HexabitzGit/H23R3x-Hardware/README.md

# H23R3x-Hardware
Hexabitz BlueNRG-M2 Bluetooth Module Hardware Design
