HexabitzGit/H23R3x-Hardware/H23R30/Documentation/H23R30_Bot.jpg

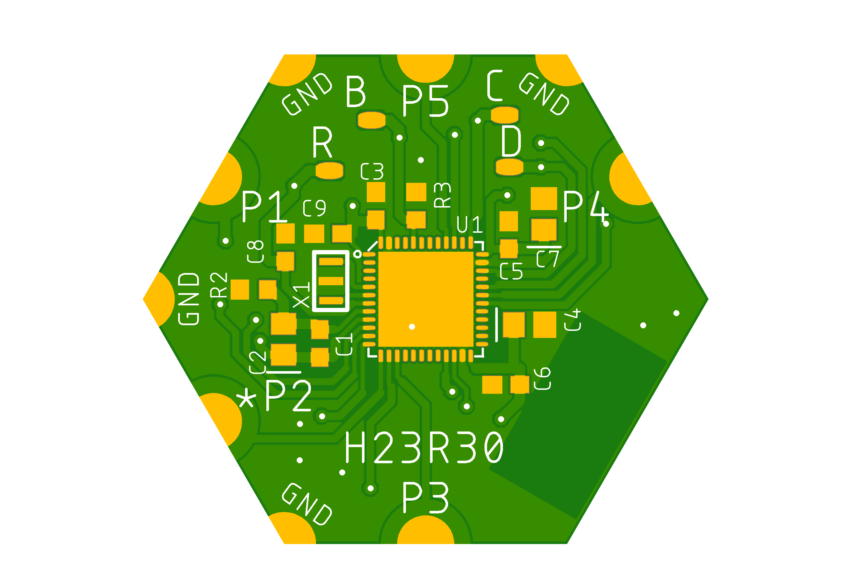
H23R30/Documentation/H23R30_Bot.jpg
