HexabitzGit/H23R3x-Hardware/H23R30/Documentation/H23R30_Top.jpg

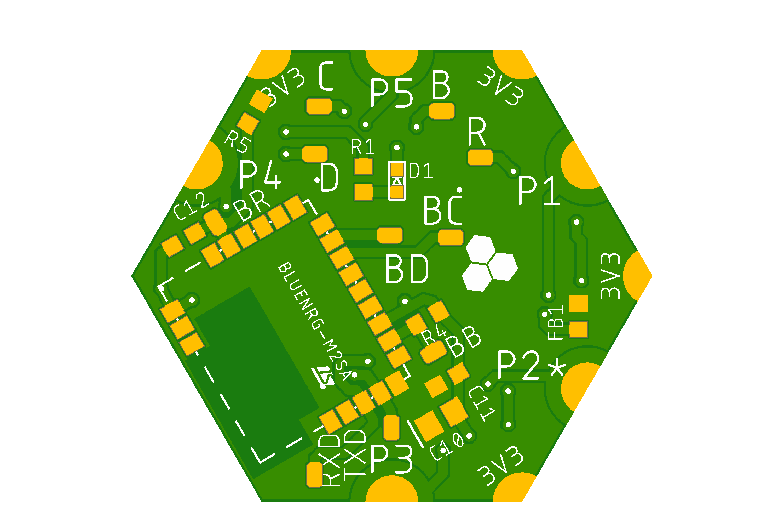
H23R30/Documentation/H23R30_Top.jpg
