HexabitzGit/H23R3x-Hardware/H23R30/Released/BOM/H23R30_BOM.xlsx

Qty | Value | Designator | Description | CAPACITANCE | MFN | MPN | OCTOPART_URL | TOLERANCE
1 | 0.0R | R2 | Thick Film Resistors - SMD 0603 |  | Yageo | RC0603JR-070RL | https://octopart.com/rc0603jr-070rl-yageo-1241539?r=sp&s=X2NteqRjRNWrnx42Y0aliA
1 | 270.0R | R1 | Thick Film Resistors - SMD 0603 |  | Yageo | RC0603FR-07270RL | https://octopart.com/search?q=RC0603FR-07270RL&start=0 | 1%
1 | 4.7K | R5 | Thick Film Resistors - SMD 0603 |  | Yageo | RC0603JR-074K7L | https://octopart.com/rc0603jr-074k7l-yageo-55458509?r=sp | 5%
2 | 10.0K | R3, R4 | Thick Film Resistors - SMD 0603 |  | Yageo | RC0603JR-0710KL | https://octopart.com/search?q=RC0603JR-0710KL&start=0 | 5%
1 | 10nF | C1 | CAP CER 10% X7R 0603 | 10nF | KEMET | C0603C103K5RACTU | https://octopart.com/c0603c103k5ractu-kemet-133094?r=sp&s=R_iPBxLnSmGqhkU2rIMFpg | 10%
7 | 100nF | C5, C11, C12, C3, C6, C8, C9 | CAP CER 10% X7R 0603 | 100nF | KEMET | C0603C104K8RACTU | https://octopart.com/c0603c104k8ractu-kemet-145075?r=sp&s=9bS9ASSwSEqMCE9KBEQZ0g | 10%
1 | 1.00uF | C2 | Cap Tant Solid SMD 2012 | 1.00uF | Yageo | CC0805KKX7R7BB105 | https://octopart.com/cc0805kkx7r7bb105-yageo-8376555?r=sp&s=YKl1wwtkROau_X5nniH2ig | 10%
3 | 4.7uF | C4, C7, C10 | Cap Tant Solid SMD 2012 | 4.7uF | Murata | GRM21BC81E475KA12L | https://octopart.com/grm21bc81e475ka12l-murata-10331911?r=sp&s=RY3qZSD8T6mG6TC9CHI5qQ | 10%
1 | BLUENRG-M2SA | U2 | Embedded ST BlueNRG-2 BLE SoC |  | STMicroelectronics | BlueNRG_M2SA | https://octopart.com/bluenrg-m2sa-stmicroelectronics-104772812?r=sp
1 | FB-TDK_MMZ1608Y300B | FB1 | Ferrite Beads Multi-Layer 30Ohm 25% 100MHz 1.5A 50mOhm DCR 0603 |  | TDK | MMZ1608Y300B | https://octopart.com/mmz1608y300b-tdk-368280?r=sp&s=cd9_2ZEqQ9q9UNBuQgHAiA
4 | PAD1 | B, C, D, R
6 | PAD4 | BB, BC, BD, BR, RXD, TXD
1 | RED | D1 | Red 0603 Clear 54 mcd 2 V Surface Mount ChipLED ; |  | Vishay | VLMS1300-GS08 | https://octopart.com/vlms1300-gs08-vishay-21709201?r=sp&s=_gcP4_q8T1SC6PJQPTQ9yA
1 | STM32F091CBU6 | U1 | MCU 32-bit ARM Cortex M0 RISC 128KB Flash 2.5V/3.3V 48-Pin UFQFPN |  | STMicroelectronics | STM32F091CBU6 | https://octopart.com/stm32f091cbu6-stmicroelectronics-51988677?r=sp&s=bU6fpgsrTZOxHyt7jkfh3w
1 | XTALL_CSTCE8M00G52 | X1 | MURATA Ceramic Resonator 8MHz ±0.5% (Tol) ±0.2% (Stability) 33pF 40Ohm 3-Pin CSMD |  | Murata | CSTNE8M00G550000R0 | https://octopart.com/cstne8m00g550000r0-murata-91406934?r=sp
