HexabitzGit/H23R3x-Hardware/H23R30/Released/3D Models/H23R30.step

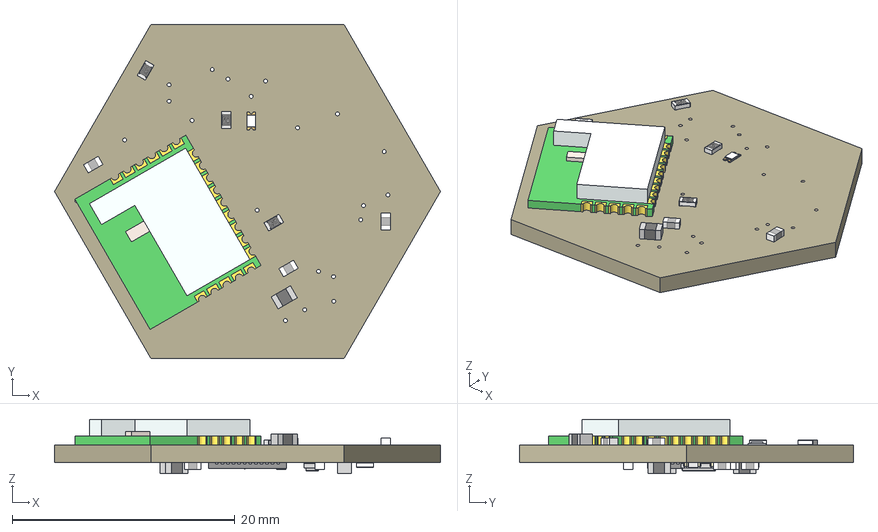
[picture p3: CAD file, 2020-07-29]
H23R30/Released/3D Models/H23R30.step
34.6 x 30.0 x 4.87 mm
Board
100nF x 8
Ferrite x 4
Contact x 8
Pins
Dome
FB-TDK_MMZ1608Y300B
4.7K x 5
STM32F091CBU6
XTALL_CSTCE8M00G52
PCB
P1
