HexabitzGit/H23R3x-Hardware/(list of files, cad)

Other CAD files:
H23R30/Released/3D Models/H23R30.SLDPRT
