HexabitzGit/H23R3x-Hardware/H23R30/Documentation/H23R30 Schematics.pdf

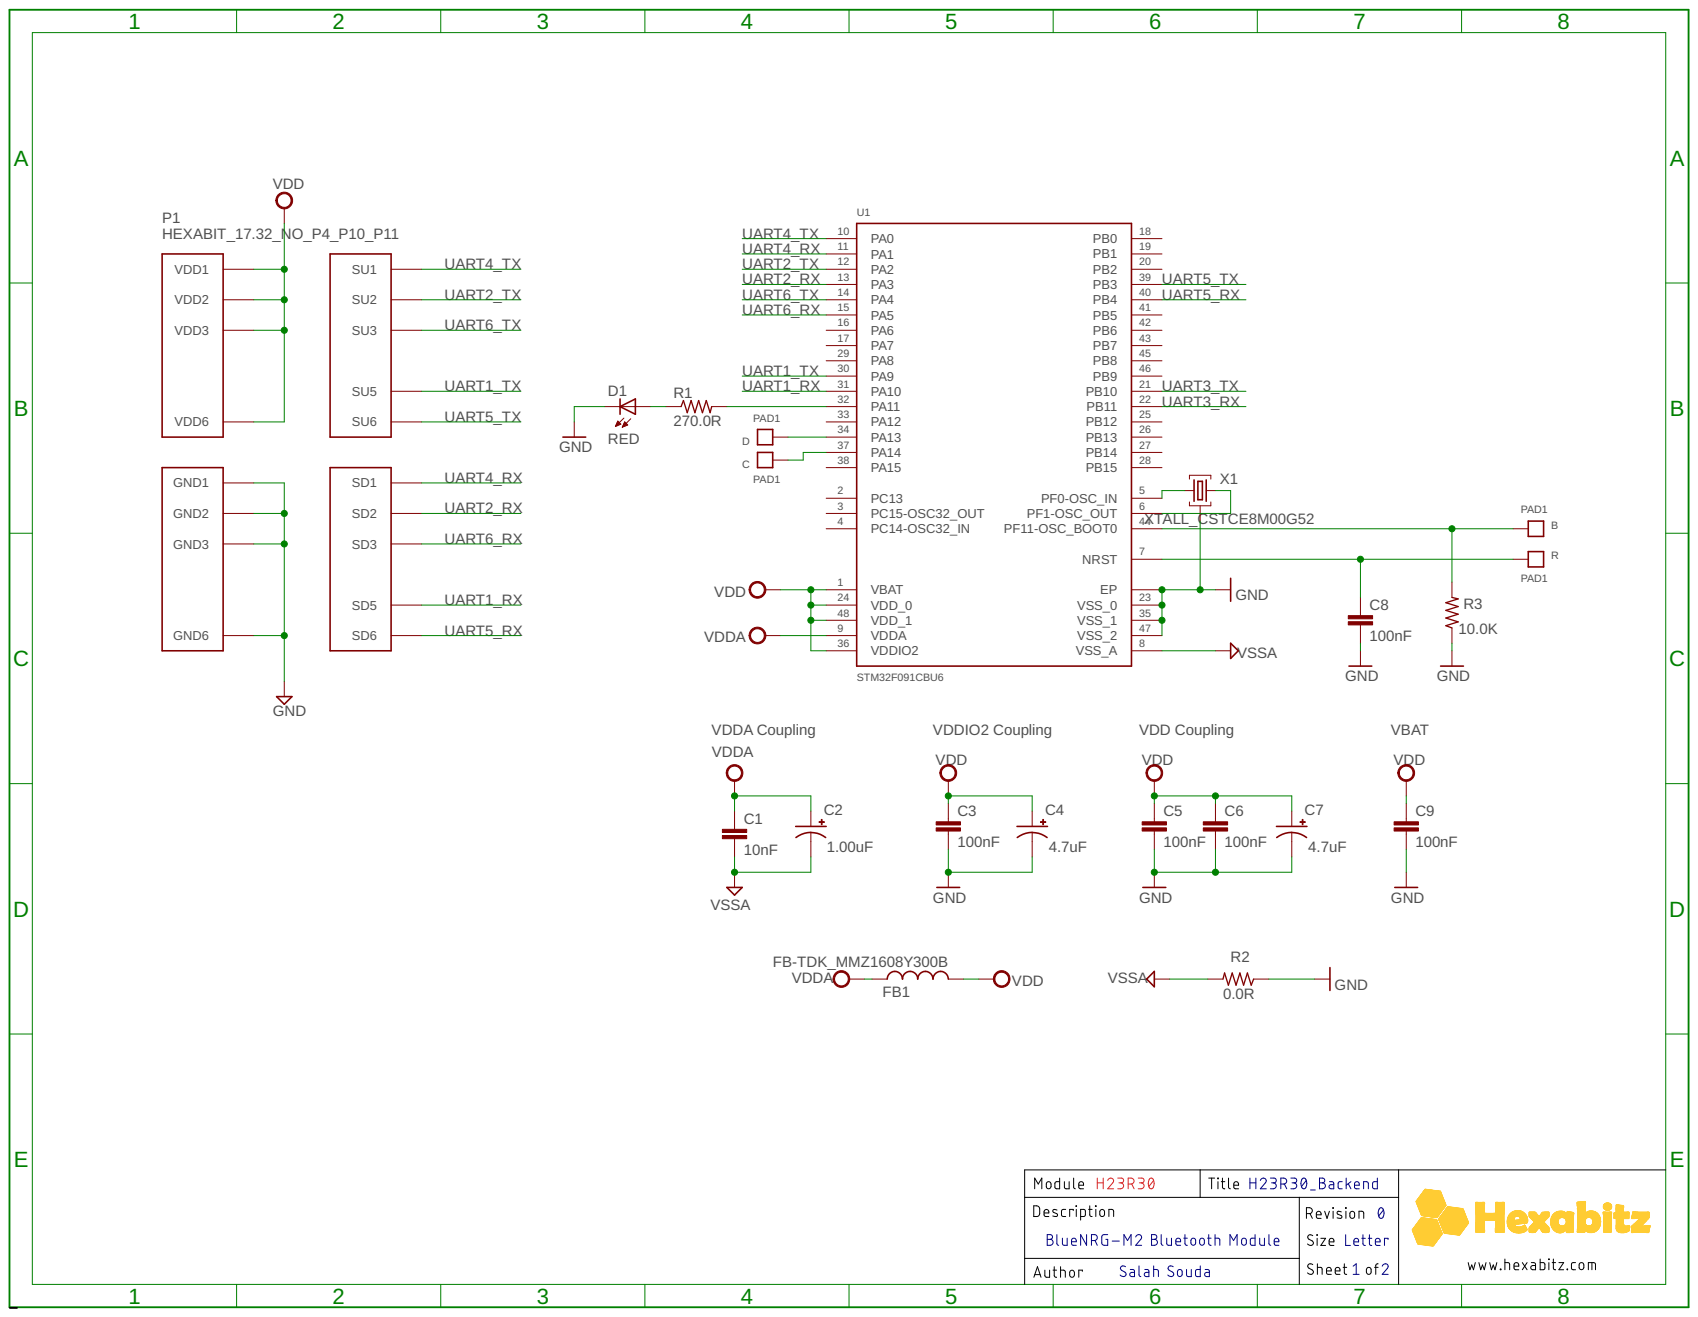
[picture p4: page 1]

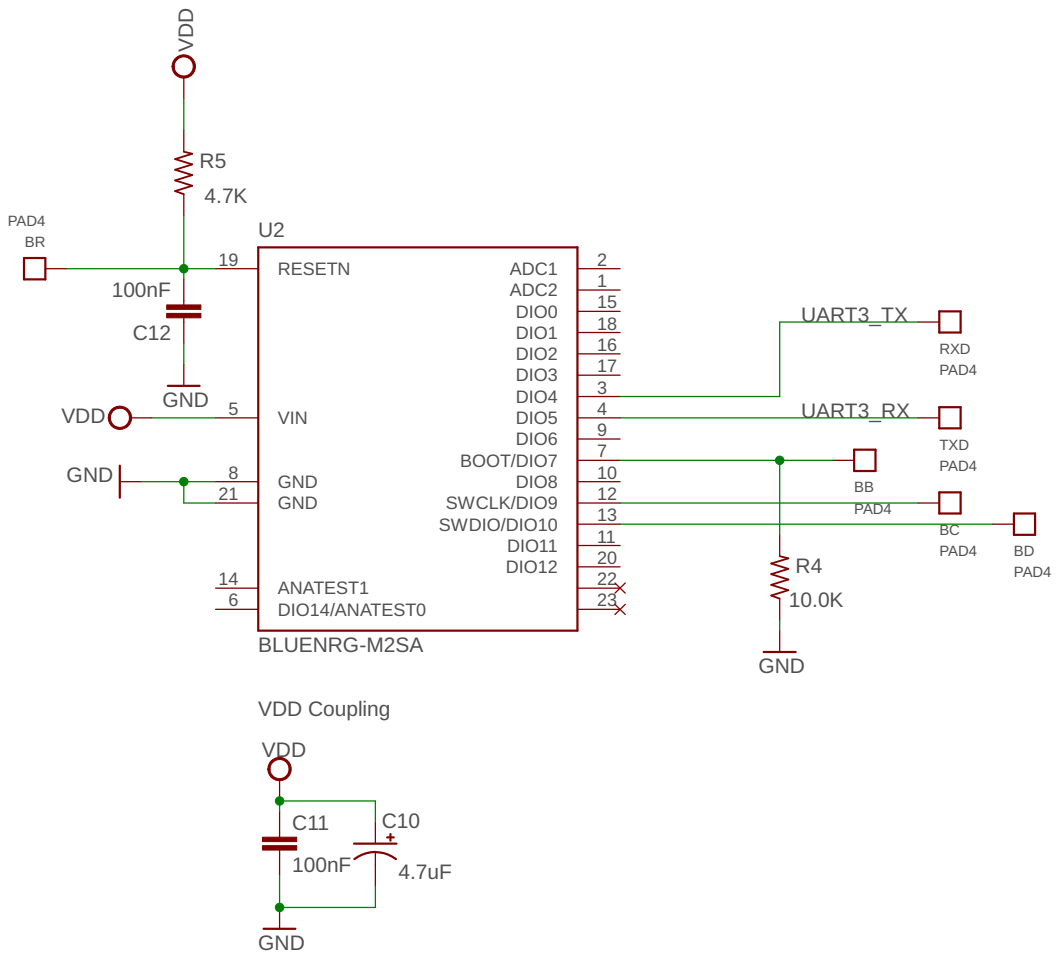
[picture p5: page 2]
