HexabitzGit/H23R3x-Hardware/H23R30/Design/H23R30.brd

## EAGLE design H23R30/Design/H23R30.brd (2021-04-21)

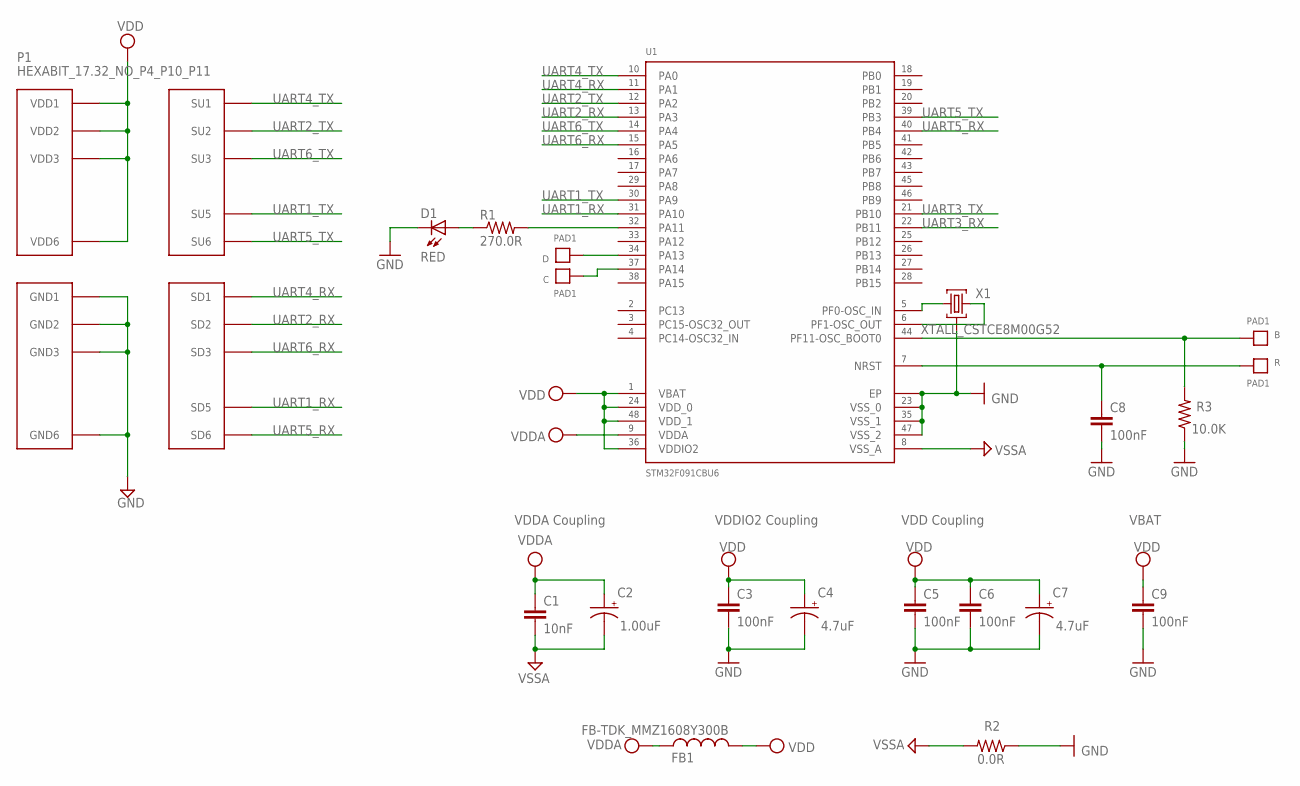
[picture p6: schematic H23R30.sch, sheet 1]

Parts:
B: PAD1
C: PAD1
C1: 10nF; C-0603; TOLERANCE 10%; VOLTAGE_RATING 50V; MPN C0603C103K5RACTU
C2: 1.00uF; C-0805-POL; TOLERANCE 10%; VOLTAGE_RATING 16V; MPN CC0805KKX7R7BB105
C3, C6, C8: 100nF; C-0603; TOLERANCE 10%; VOLTAGE_RATING 10V; MPN C0603C104K8RACTU
C4, C7: 4.7uF; C-0805-POL; TOLERANCE 10%; VOLTAGE_RATING 25V; MPN GRM21BC81E475KA12L
C5: 100nF; C-0603; TOLERANCE 10%; VOLTAGE_RATING 10; MPN C0603C104K8RACTU
C9: 100nF; C-0603; TOLERANCE 10V; VOLTAGE_RATING 10%; MPN C0603C104K8RACTU
D: PAD1
D1: RED; VLMS1300-GS08; MPN VLMS1300-GS08
FB1: FB-TDK_MMZ1608Y300B; MPN MMZ1608Y300B
P1: HEXABIT_17.32_NO_P4_P10_P11
R: PAD1
R1: 270.0R; R-0603; TOLERANCE 1%; MPN RC0603FR-07270RL
R2: 0.0R; R-0603; MPN RC0603JR-070RL
R3: 10.0K; R-0603; TOLERANCE 5%; MPN RC0603JR-0710KL
U1: STM32F091CBU6
X1: XTALL_CSTCE8M00G52

Connections:
B1: B.P$1, B.P$2, R3.2, U1.P$44 (PF11-OSC_BOOT0)
GND: C3.2, C4.2 (-), C5.2, C6.2, C7.2 (-), C8.2, C9.2, D1.C, P1.PAD_PD7 (GND1), P1.PAD_PD8 (GND2), P1.PAD_PD9 (GND3), P1.PAD_PD12 (GND6), R2.1, R3.1, U1.EP, U1.P$23 (VSS_0), U1.P$35 (VSS_1), U1.P$47 (VSS_2), X1.P$2 (2); also elsewhere on the board
unnamed: R1.2, U1.P$32 (PA11)
unnamed: D1.A, R1.1
unnamed: U1.P$5 (PF0-OSC_IN), X1.P$1 (1)
unnamed: U1.P$6 (PF1-OSC_OUT), X1.P$3 (3)
unnamed: D.P$1, D.P$2, U1.P$34 (PA13)
unnamed: C.P$1, C.P$2, U1.P$37 (PA14)
R1: C8.1, R.P$1, R.P$2, U1.P$7 (NRST)
UART1_RX: P1.PAD_PD5 (SD5), U1.P$31 (PA10)
UART1_TX: P1.PAD_PU5 (SU5), U1.P$30 (PA9)
UART2_RX: P1.PAD_PD2 (SD2), U1.P$13 (PA3)
UART2_TX: P1.PAD_PU2 (SU2), U1.P$12 (PA2)
UART3_RX: U1.P$22 (PB11); also elsewhere on the board
UART3_TX: U1.P$21 (PB10); also elsewhere on the board
UART4_RX: P1.PAD_PD1 (SD1), U1.P$11 (PA1)
UART4_TX: P1.PAD_PU1 (SU1), U1.P$10 (PA0)
UART5_RX: P1.PAD_PD6 (SD6), U1.P$40 (PB4)
UART5_TX: P1.PAD_PU6 (SU6), U1.P$39 (PB3)
UART6_RX: P1.PAD_PD3 (SD3), U1.P$15 (PA5)
UART6_TX: P1.PAD_PU3 (SU3), U1.P$14 (PA4)
VDD: C3.1, C4.1 (+), C5.1, C6.1, C7.1 (+), C9.1, FB1.2, P1.PAD_PU7 (VDD1), P1.PAD_PU8 (VDD2), P1.PAD_PU9 (VDD3), P1.PAD_PU12 (VDD6), U1.P$1 (VBAT), U1.P$24 (VDD_0), U1.P$36 (VDDIO2), U1.P$48 (VDD_1); also elsewhere on the board
VDDA: C1.1, C2.1 (+), FB1.1, U1.P$9 (VDDA)
VSSA: C1.2, C2.2 (-), R2.2, U1.P$8 (VSS_A)

Notes on the sheet:
VDDA Coupling
VDDIO2 Coupling
VDD Coupling
VBAT

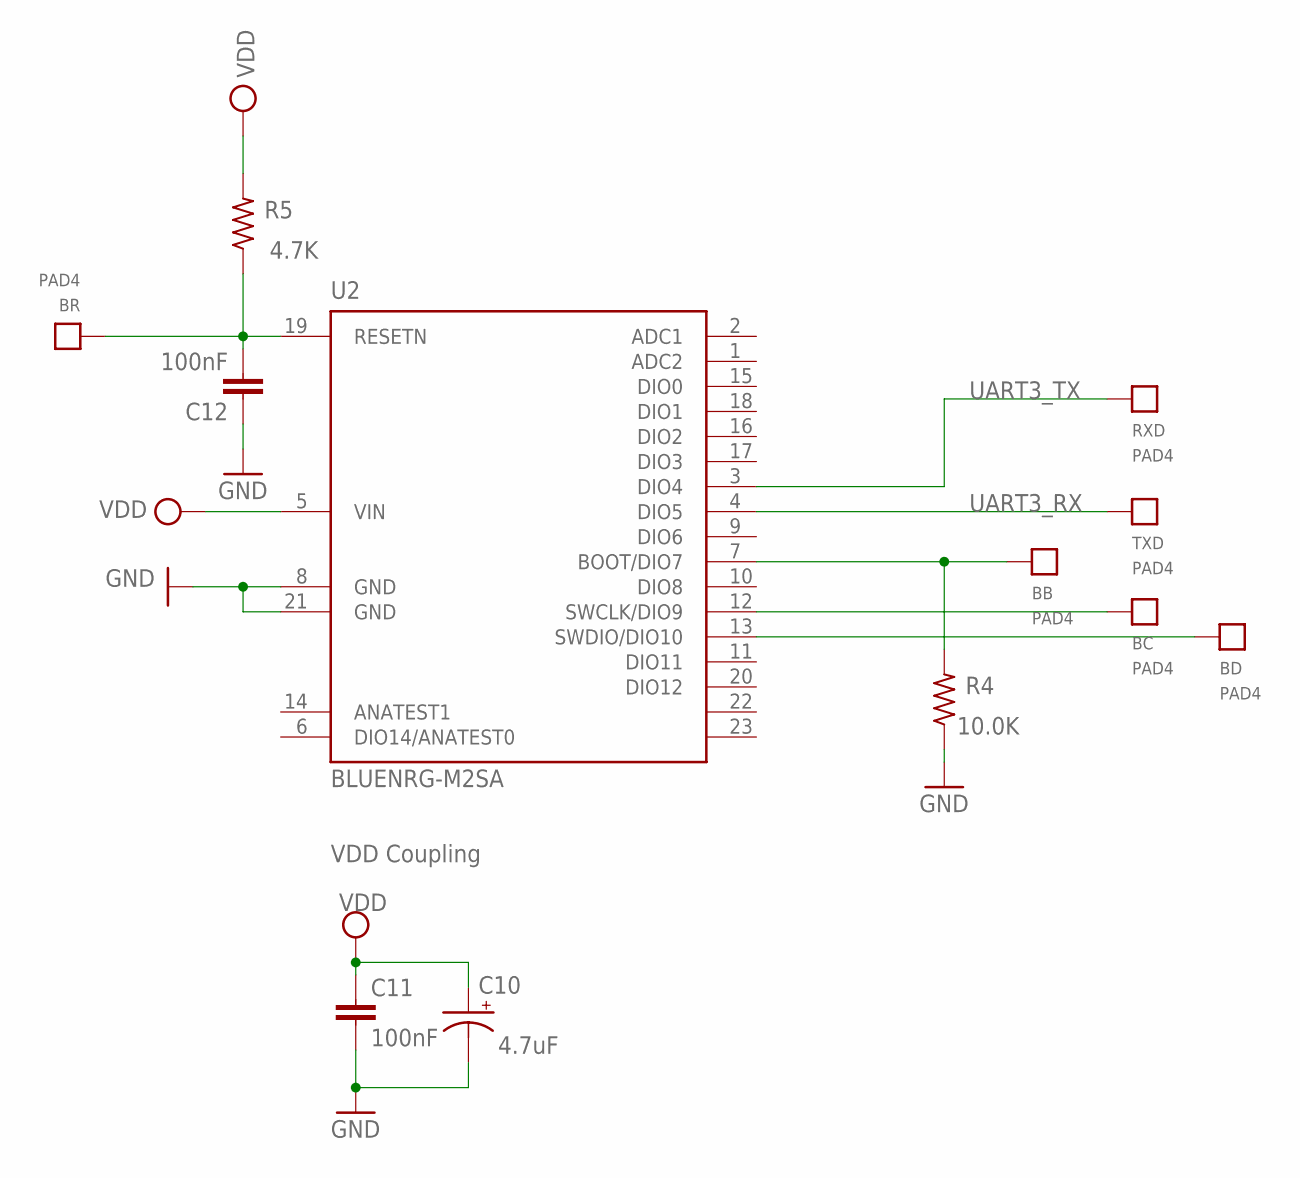
[picture p7: schematic H23R30.sch, sheet 2]

Parts:
BB: PAD4
BC: PAD4
BD: PAD4
BR: PAD4
C10: 4.7uF; C-0805-POL; TOLERANCE 10%; VOLTAGE_RATING 25V; MPN GRM21BC81E475KA12L
C11, C12: 100nF; C-0603; TOLERANCE 10%; VOLTAGE_RATING 10; MPN C0603C104K8RACTU
R4: 10.0K; R-0603; TOLERANCE 5%; MPN RC0603JR-0710KL
R5: 4.7K; R-0603; TOLERANCE 5%; MPN RC0603JR-074K7L
RXD: PAD4
TXD: PAD4
U2: BLUENRG-M2SA; BLURNGR-M2SA_FOOTPRINT

Connections:
B2: BB.P$1, R4.2, U2.7 (BOOT/DIO7)
GND: C10.2 (-), C11.2, C12.1, R4.1, U2.8 (GND), U2.21 (GND); also elsewhere on the board
unnamed: BD.P$1, U2.13 (SWDIO/DIO10)
unnamed: BC.P$1, U2.12 (SWCLK/DIO9)
unnamed: BR.P$1, C12.2, R5.1, U2.19 (RESETN)
UART3_RX: TXD.P$1, U2.4 (DIO5); also elsewhere on the board
UART3_TX: RXD.P$1, U2.3 (DIO4); also elsewhere on the board
VDD: C10.1 (+), C11.1, R5.2, U2.5 (VIN); also elsewhere on the board

Notes on the sheet:
VDD Coupling

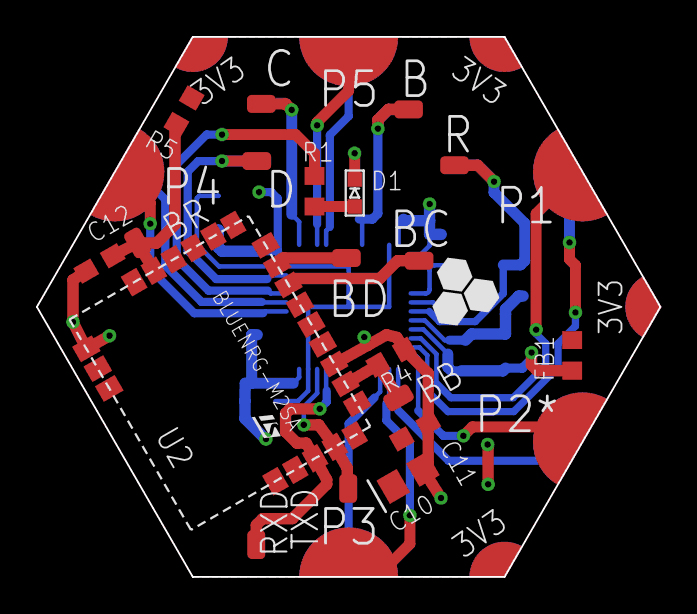
[picture p8: board H23R30.brd from above]

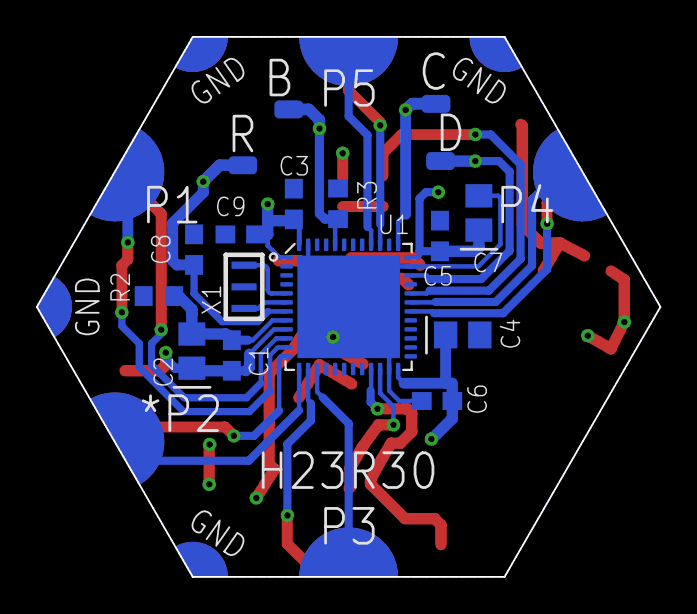
[picture p9: board H23R30.brd from below]

Board: 2 copper layers, 34.6 x 30.0 mm, 33 parts (13 on the bottom side), 28 nets.
