HexabitzGit/H23R3x-Hardware/(commit log)

2020-07-11 Copying script generated files
    [H23R30.brd, H23R30.sch]
2020-07-18 Bluetooth BlueNRG module
    [H23R30.SLDPRT, H23R30.brd, H23R30.sch, H23R30_BOM.xlsx]
2020-07-29 FIX and add 3D Step Model
    [H23R30.SLDPRT, H23R30.step]
2021-04-18 Release REV 1
    [H23R30.brd, H23R30.sch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]
2021-04-18 H23R31 BOM
    [H23R31_BOM.xlsx]
2021-04-21 Fix To REV0
    [H23R30.brd, H23R30.sch, H23R30_BOM.xlsx, H23R31_BOM.xlsx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]
